delos19/LATVIS-Electronic-Systems-Documentation/README.md

# LATVIS-Electronic-Systems-Documentation
This documentation ties together the CAN Variable Actuation System (CANVAS) PCB and the Static Interactive Display (SID) together

This document was created and is modified currently on Overleaf.
