delos19/LATVIS-Electronic-Systems-Documentation/main.tex

 \documentclass{article}
\usepackage[utf8]{inputenc}
\usepackage{graphicx}
\usepackage[english]{babel}
\usepackage[protrusion=true,expansion =true]{microtype}   
\usepackage{amsmath,amsfonts,amsthm,amssymb}
\usepackage{graphicx,epsfig,epsf,fancyhdr}
\usepackage{graphicx}
\usepackage{cite}
\usepackage{float}
\usepackage{titlepic}
\usepackage[export]{adjustbox}
\usepackage{pdfpages}
\usepackage{soul}
\usepackage{appendix}
\usepackage{nomencl}
\usepackage{etoolbox}
\usepackage{typearea}
\usepackage{gensymb}
\usepackage{caption}
\usepackage{hyperref}
\usepackage[table,xcdraw]{xcolor}
\usepackage{placeins}
\usepackage{amssymb}
%\documentclass[xcolor=table]{beamer}
\usepackage[a4paper,pdftex]{geometry}    % A4paper margins
\setlength{\oddsidemargin}{5mm}            % Remove 'twosided' indentation
\setlength{\evensidemargin}{5mm}
\usepackage{setspace}
\usepackage[load-configurations = abreviations]{siunitx}
\usepackage{listings}
\usepackage{xcolor}
 
\definecolor{codegreen}{rgb}{0,0.6,0}
\definecolor{codegray}{rgb}{0.5,0.5,0.5}
\definecolor{codepurple}{rgb}{0.58,0,0.82}
\definecolor{backcolour}{rgb}{0.95,0.95,0.92}
 
\lstdefinestyle{mystyle}{
    backgroundcolor=\color{backcolour},   
    commentstyle=\color{codegreen},
    keywordstyle=\color{magenta},
    numberstyle=\tiny\color{codegray},
    stringstyle=\color{codepurple},
    basicstyle=\ttfamily\footnotesize,
    breakatwhitespace=false,         
    breaklines=true,                 
    captionpos=b,                    
    keepspaces=true,                 
    numbers=left,                    
    numbersep=5pt,                  
    showspaces=false,                
    showstringspaces=false,
    showtabs=false,                  
    tabsize=2
}
\lstset{style=mystyle}

\title{Linear Actuated Variable Intake System (LATVIS)}
\author{John Wiggins }
\date{December 2019}

\usepackage{natbib}
\usepackage{graphicx}

\begin{document}

\maketitle

\begin{figure}[h!]
\centering
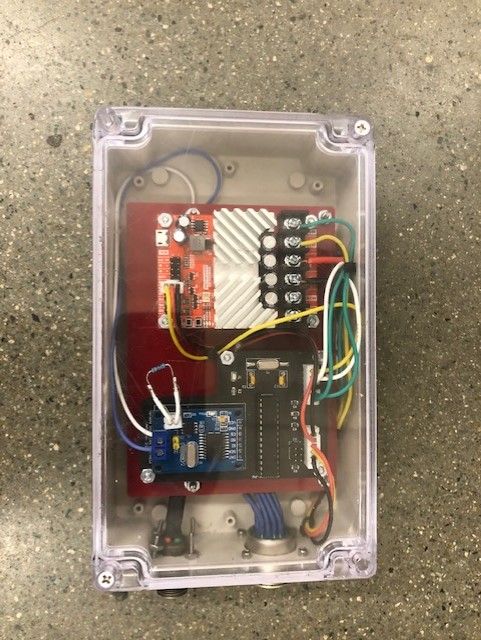
[picture p1: Electronics_Housing.jpg]

\caption{Electronics Housing Assembly}
\label{fig:assembly}
\end{figure}

\section{Introduction}
The goals of this project were to develop a lightweight electronics housing system that could communicate via CAN bus. The RPM of the AR 20 vehicle would be then logged onto a microprocessor and converted to length, via the Helmholtz relationship between length and RPM.

\section{Components}
This project was split into two major subsystems. The first subsystem is the On-Board controller housing that lives in the Side-Pod. The second subsystem is the Simulated Interactive Display (SID) that allowed for tuning of the electronics system without the car running.
\subsection{On-Board systems}
The on-board system has two main components: The roboclaw motor controller and the custom CAN to SPI conversion Micro-Controller, known as CAN Variable Actuation System (CANVAS).

\subsubsection{RoboCLaw}
The RoboClaw motor controller controls the actuator's DC motor via a PWM signal from the CANVAS board. 
\newline 
\begin{figure}[h!]
\centering
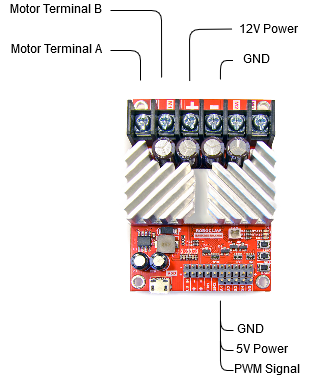
[picture p2: ME_490_Drawings.png]

\caption{RoboClaw Project Wiring Diagram}
\label{fig:roboclaw}
\end{figure}

These are a few notes about the modes and operation of the RoboClaw:
\begin{itemize}
    \item The board is set to be in ANALOG MODE 3 for PWM interpretation.
    \item The board regulates the power for the CANVAS board down to 5V which is is the primary source of power for the board. It saved the project having to add an external voltage regulator or separate power source for the CANVAS board.
    \item The rapid indicator flashing notes that it is receiving signals.
    \item Do not attempt to use serial for communication with the RoboClaw for this project. There was success using serial, however, the CANVAS board was having trouble with dual serial communications and worked more reliably using PWM.
\end{itemize}

\subsubsection{CANVAS PCB}
The CANVAS PCB operates as the MCU for the on-board system. With an integrated CAN Bus converter, the board operates as the interface between the vehicle and the motor controller. For more information on the board, refer to the CANVAS PCB Design section. 

\begin{figure}[h!]
\centering
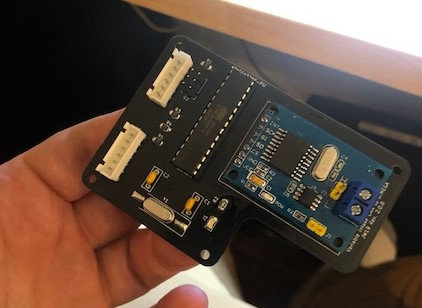
[picture p3: pcb_2.jpg]

\caption{CANVAS Board upon initial completion}
\label{fig:CANVAS_WorkBench}
\end{figure}

\section{CANVAS PCB Design}
\section{CAN Communication Notes}
This section will go into detail on the CAN communication notes for this particular project. CAN communication within the few systems prooved itself to be a challenge and here are some notes that helped the project overcome these.
\subsection{Parameters}
The project parameters were found via sniffing the line with a Saleae Logic Analyzer and Motec documentation. Here are is a list of data points that were logged:

\begin{center}
\begin{tabular}{ | c | c | }
\hline
 \textbf{Motec Baud Rate} & 1 Mbps \\ 
 \hline
 \textbf{Mask} & 0xFF \\ 
 \hline
 \textbf{Channel} & 0x520 \\    
 \hline
 \textbf{Type of CAN} & Standard \\
 \hline
 \textbf{Array Length} & 8 \\
 \hline
 \textbf{Byte to RPM Conversion Factor} & x100\\
 \hline
\end{tabular}
\end{center}

\subsection{Hardware and Testing}
The hardware use to convert the CAN signal to SPI was the NiRen MCP2515 Can breakout board. This board uses the MCP2515 chip as the main processing IC and allows for easy integration of the breakout board into any test system.
\begin{figure}[H]
\centering
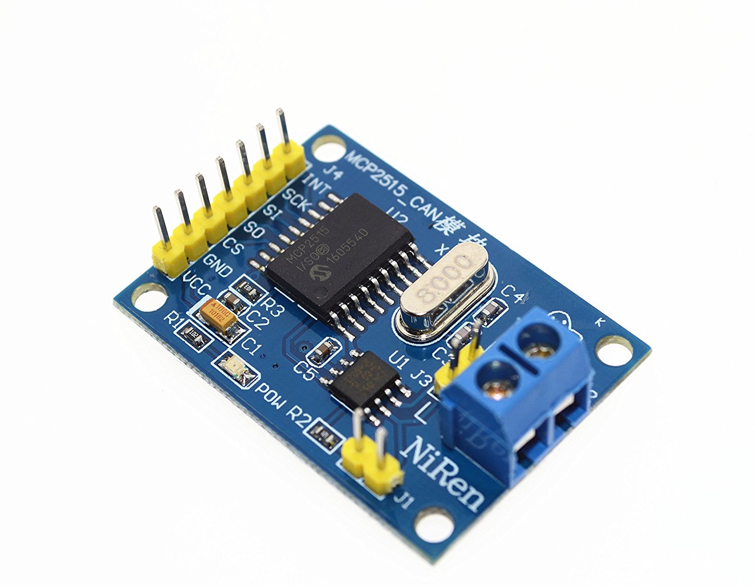
[picture p4: NiRen.jpg]

\caption{NiRen MCP2515 CAN Breakout Board}
\label{fig:NiRen}
\end{figure}

The first step that was taken was using the example code found on the MCP2515 Seeed-Studio library to verify the boards worked. The library can be found \href{https://github.com/Seeed-Studio/CAN_BUS_Shield}{\underline{here on github}}. The set-up looked as the following:
\begin{figure}[H]
\centering
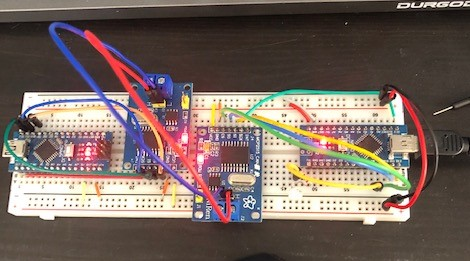
[picture p5: CAN_Test.jpg]

\caption{CAN Communication Test Setup}
\label{fig:NiRen}
\end{figure}

There were three errors that occurred with the setup in Figure 5 that needed to be adjusted in order to obtain communication between the two boards. The two notable changes were:
\begin{itemize}
    \item \textbf{Terminating Resistor:} Add 120 Ohm terminating resistor to at least one side of the communication. It does not matter which side you add it to, however the system must have one to obtain communication. One was added to the board to ensure there was always one in the loop.
    \item \textbf{16 Mhz Clock:} In order to use the arduino MCP2515 Library, the boards require a 16 Mhz clock. The NiRen boards to not come assembled with one, but rather a 8 Mhz clock. Replacing the clock to a 16 Mhz clock solve this communication issue.
    \item \textbf{CAN Wires Have a Max Length:} During testing, a 5 ft long cable was used to test communication across the two boards, due to the distance between the test computer and the test bench. The signal could not complete this length without developing errors and a switch to a shorter length fixed this issue. According to the National Instruments website, at 1 Mbit/Sec, while the Bus Length can go up to 131 ft, the max Cable Stub Length, which is what this system is concerned with, is 1 ft. Thus, using an extended cable was not going to work and a shorter cable did resolve this issue. 
\end{itemize}

After making these adjustments, the communication issues were resolved and the boards were able to send the sample messages across.
\bigskip

The next step was to test the CAN communication to the CANVAS board. This involved running jumpers to the boards CAN terminals and rewriting the buffer array to have all zeros except the 0-th byte, which contained anywhere between a 0 to 255. 
\[\textrm{buf}[8] = [150,0,0,0,0,0,0,0];\]
Multiplying this value by the RPM conversion factor of 100, converts, for example, a 42 to 4200, which would be the example RPM. Thus, sending a 150 would be 15000 which is close to the max value the vehicle would be sending and a good test value for a fully contracted verification of communication. 
\subsection{Library and Coding}
The MCP Can library used had a few key functions that helped send/recieve messages.
\subsubsection{Receiving Messages}
Below is an example of Receiving Messages that comes with the library. It covers the the main calls and setup of checking a received code. This was also the same code used to sniff the line on the AR-20 Vehicle and verify the data was being recieved.
\lstinputlisting[language=C++]{receive_check.ino}

\section{Static Interactive Display (SID)}
\section{Vehicle Constraints}
\section{Manufacturing}
\section{Safety}

\section{Operation}
In order to operate the system safely, please follow these steps on powering up, powering down, and controlling the system.
\subsection{Powering Up}
\subsubsection{Normal Driving Operation (NDO)}
Normal Driving Operation (NDO) is used when vehicle is to be driven around.
\begin{enumerate}
    \item Verify all connections are secure on the vehicle (Under-Dash CAN, Actuator Clip, and Side-Pod Terminals).
    \item Turn the power safety clip on the drivers right hand side of the vehicle to the ON position.
    \item Wait for power on sequence. (NOTE: Actuator will move to lowest position).
    \item System is ready to drive.
\end{enumerate}
\subsubsection{Bench Power and Simulated RPM}
Bench Power is for when the vehicle is static and power does not want to be drained from on-board battery. To move actuator, use of the SID will be needed.
\begin{enumerate}
    \item Lift and secure Side-Pod on the side of the vehicle.
    \item Remove screws from top acrylic cover of actuator casing.
    \item Remove the 2-Prong Power connectors to the vehicle on the lower left side of the casing. This keeps the rest of the vehicle from getting power and turning on the built in CAN bus system from the Motec ECU.
    \item Verify bench power supply is \textit{NOT} connected to the vehicle.
    \item Turn ON bench power supply and verify the output voltage is set to 12V.
    \item Turn OFF bench power supply.
    \item Reach under dash and disconnect CAN bus terminals.
    \item Connect the CAN bus terminal going to the sidepod to the SID CAN bus line.
    \item Connect the power and ground terminals of the Roboclaw to the bench power supply.
    \item Connect the SID to power via Mini USB.
    \item Power on bench power supply.
    \item Wait for startup sequence.
    \item System is ready to simulate.
\end{enumerate}

\subsection{Powering Down}
\subsubsection{Normal Driving Operation (NDO)}
To power down, turning off power to the vehicle will shutdown the system immediately. 
\newline \newline 
NOTE: If the operator wishes the actuator to go to the fully contracted position, power cycling the car will trigger the boot up sequence, which sets the actuator to the fully contracted position. Do NOT turn the vehicle back on once it is in this position as it will move the actuator automatically to the the optimized intake length for the given RPM.

\subsubsection{Bench Power and Simulated RPM}
\begin{enumerate}
    \item Move the actuator to the fully contracted position, for storage and quality maintenance of actuator.
    \item Power off the bench power supply. This guarantees the actuator is no longer able to move.
    \item Power off the SID.
    \item Reconnect the dash CAN bus clip to the built in vehicle terminal.
    \item Reconnect the Side-Pod housing to the built in vehicle power terminals.
    \item Verify all connections are restored for driving operation and close and secure Side-Pod.
\end{enumerate}

\subsection{Control via Static Interface Display (SID)}
For operating the SID, please follow these steps.
\subsubsection{Boot Up Sequence}
The SID has a boot up sequence that initialized the CAN bus inside the box. When the boot is set, the LCD monitor will display that the CAN bus has been initialized. Press the MODE button to move into the operating modes. The indicator LED will begin to glow to reflect the current user mode.
\subsubsection{RPM Tuning}
The RPM Tuning mode is controlled by the potentiometer in the middle of the base panel. The RPM is displayed on the LCD as well as the intended length and position of the actuator. This mode will run until the MODE button is pressed, indicating the mode to jump out of it's loop and upon a second press of the MODE button, will move onto the next MODE of operation.
\subsubsection{Fully Extended}
Fully Extended mode moves the actuator to the longest length the on-board Side-Pod housing controller allows. Upon arrival at this location, the user can press MODE again to jump out of the movement of the actuation and upon a secondary press, can change to the next MODE.
\newline \newline
NOTE: Do NOT click the MODE button while the actuator is moving. This will lock the movement of the actuator causing it to over extend and could damage the machine. Currently working on fixes for this issue, however for the time-being, please be aware of this and use with caution.
\subsubsection{Fully Contracted}
Fully Contracted mode move the actuator to the shortest length the on-board Side-Pod housing controller allows. Upon arrival at this location, the user can press MODE again to jump out of the movement of the actuation and upon a secondary press, can change to the next MODE.
\subsubsection{Range of Actuation Demo}
The Range of Actuation Demo allows for the demonstration of the continuous range of motion the actuator allows. This mode will toggle between fully extended and fully contracted.
\newline \newline
NOTE: To move on from this mode, hold the MODE button down until the actuation changes direction then quickly press the MODE button a second time to move onto the next position in the loop of Modes.

\section{Coding}

\section{Conclusion}
``I always thought something was fundamentally wrong with the universe'' \citep{adams1995hitchhiker}

\section{Appendix}
\subsection{Codes}

\bibliographystyle{plain}
\bibliography{references}
\end{document}
